steppenhj/Neuro-Drive-CPP/docs/hardware.md

# 하드웨어 부품 목록

Neuro-Drive 프로젝트에 사용된 전체 부품 목록입니다.

---

## MCU / MPU

| # | 구성 | 이름 | 판매처 | 비고 |
|---|---|---|---|---|
| 2 | Raspberry Pi 5 8GB | [정품] 라즈베리파이5 8GB | 아이씨팩토리 | 2/1 쇼트로 인한 고장 |
| 29 | Raspberry Pi 5 4GB | [정품] 라즈베리파이5 4GB | 아이씨팩토리 | 현재 사용 |
| 18 | STM32 NUCLEO-F411RE | ST NUCLEO-F411RE STM32 Nucleo-64 개발보드 | 무원 전자 | SensorECU (Phase 1~5) |
| 33 | STM32 NUCLEO-F446RE | NUCLEO-F446RE | 디바이스마트 | MotorECU (Phase 6 신규) |

---

## 구동계

| # | 구성 | 이름 | 판매처 |
|---|---|---|---|
| 1 | Ackermann 섀시 | 5KG 부하 Ackerman 로봇 자동차 섀시 인코더 모터 전륜 스티어링 RC 탱크 Arduino용 Raspberry Pi 키트 | 알리 |
| 4 | 모터 드라이버 HAT | Waveshare I2C interface Motor Driver HAT Raspberry Pi Onboard PCA9685 Chip | 스마트 유통 |
| 17 | 모터 드라이버 | L298N 모터드라이버 모듈 (방열판 포함) | 엘레파츠 |

> ⚠️ **고장**: #1 Ackermann 섀시의 **조향 서보가 Phase 6(CAN 마이그레이션) 중 소손(탐)** → 현재 구동계 사용 불가. 단순 사고가 아니라 *전진(2번째 MCU + CAN 추가)의 비용* — 이 실패가 multi-mcu-can으로 CAN 멀티노드 기본기를 단단히 다지는 계기가 됨(차량전장·방산 체계통합 직결 자산). Neuro-Drive의 *"실패에서의 재설계"* 와 같은 결.

---

## 전원계

| # | 구성 | 이름 | 판매처 |
|---|---|---|---|
| 5 | 충전기 세트 | IMAX B6 충전기 + 12V 5A 파워서플라이 세트 | 수성RC |
| 8 | LiPo 배터리 | B2200N-SP35 (7.4V, 2S1P, 35C+/JST-XT) 리튬 폴리머 배터리 | 링크드론 |
| 9 | 충전 케이블 | XT60 충전 케이블 | 링크드론 |
| 10 | 배터리-모터드라이버 연결 | XT60H(수) 케이블 연결 커넥터 (10cm) | 링크드론 |
| 25 | 레귤레이터 | UBEC 5A (입력 5V~30V / 출력 5V 5A) | 팰콘샵 |
| 26 | XT60 케이블 | XT60 전원 케이블 (10cm) | 팰콘샵 |
| 27 | 스플리터 | XT60 병렬 커넥터 케이블 Type 2 | 팰콘샵 |
| 28 | UBEC 연결 커넥터 | 와고 전선 커넥터 4SQ 직결 연결 221-2411 | 와고스토어 |
| 31 | 어댑터 | 5V 5A 45W 호환 어댑터 | 아이씨팩토리 |

---

## 통신 / 센서

| # | 구성 | 이름 | 판매처 | 비고 |
|---|---|---|---|---|
| 34 | MCP2515 CAN 모듈 × 2 | MCP2515 + TJA1050 트랜시버 모듈 | 고소미소미 | RPi5 SPI→CAN 인터페이스 |
| 35 | MCP2551 트랜시버 모듈 | MCP2551 CAN 트랜시버 | 농삼비 | F446RE bxCAN 인터페이스 |
| 36 | HC-SR04P 초음파 센서 | HC-SR04P | 디바이스마트 | 장애물 감지 (SensorECU) |
| 37 | 종단 저항 | 120Ω 저항 | 디바이스마트 | CAN 버스 양단 종단 |
| 38 | 브레드보드 | 브레드보드 400홀 | 디바이스마트 | CAN 배선용 |

---

## 카메라

| # | 구성 | 이름 | 판매처 |
|---|---|---|---|
| 21 | 카메라 모듈 | 공식 라즈베리파이 카메라 모듈 3 12MP IMX708 자동초점 120도 | 알리 (IceCrab Store) |
| 22 | 카메라 케이블 | RPi5/Zero용 15핀-22핀 FFC 플렉시블 케이블 | 알리 (IceCrab Store) |
| 23 | 카메라 거치대 | 라즈베리파이 카메라 거치대 브라켓 케이스 | 톡톡테크 |

---

## 저장 / 주변기기

| # | 구성 | 이름 | 판매처 |
|---|---|---|---|
| 3 | 쿨러 | [정품] 라즈베리파이5 액티브 쿨러 | 무원전자 |
| 6 | SD카드 | 샌디스크 Micro SD 128GB | 쿠팡 |
| 7 | SD카드 리더기 | 마이크로 SD카드리더기 C타입 | 아이엠듀 스토어 |
| 19 | Mini USB 2.0 케이블 | — | 쿠팡 |
| 30 | RPi5 케이스 | [정품] 라즈베리파이5 케이스 | 아이씨팩토리 |

---

## 배선 / 소모품

| # | 구성 | 이름 | 판매처 |
|---|---|---|---|
| 11 | 점퍼 케이블 | 40핀 아두이노 점퍼케이블 20cm 암수·암암 | 쿠팡 |
| 12 | 정밀 드라이버 | WERA 2035 전자 정밀 일자(-) 드라이버 | Wera |
| 13 | 스태킹 헤더 | 라즈베리파이 GPIO 스태킹 암 헤더 키트 | 11번가 |
| 14 | 나사 키트 | PCB 황동서포트 120P 키트 M2.5/M3 | 쿠팡 |
| 15 | 케이블 타이 | PA66 케이블타이 대/중/소 각 100개 | 쿠팡 |
| 16 | 덕트 테이프 | 스코라 덕트 테이프 검정 5cm × 15m | 쿠팡 |
| 24 | 점퍼선 (추가) | 20cm 수-수, 암-수 | 쿠팡 |
| 32 | M2.5/M3 나사 키트 | 라즈베리파이용 나일론 나사 너트 키트 20종 | 엠제이로지스트리플 |
