steppenhj/Neuro-Drive-CPP/firmware/F446RE/src/main.h

#define MOTOR_PWM_MAX 999
#define SERVO_MIN_US 650
#define SERVO_MAX_US 2350
#define SERVO_CENTER_US 1500
#define PWM_TO_ENC_SCALE 0.1f
#define B1_Pin GPIO_PIN_13
#define B1_GPIO_Port GPIOC
#define B1_EXTI_IRQn EXTI15_10_IRQn
#define MOTOR_IN1_Pin GPIO_PIN_1
#define MOTOR_IN1_GPIO_Port GPIOA
#define USART_TX_Pin GPIO_PIN_2
#define USART_TX_GPIO_Port GPIOA
#define USART_RX_Pin GPIO_PIN_3
#define USART_RX_GPIO_Port GPIOA
#define MOTOR_IN2_Pin GPIO_PIN_4
#define MOTOR_IN2_GPIO_Port GPIOA
#define LD2_Pin GPIO_PIN_5
#define LD2_GPIO_Port GPIOA
#define TMS_Pin GPIO_PIN_13
#define TMS_GPIO_Port GPIOA
#define TCK_Pin GPIO_PIN_14
#define TCK_GPIO_Port GPIOA
#define SWO_Pin GPIO_PIN_3
#define SWO_GPIO_Port GPIOB
