steppenhj/Neuro-Drive-CPP/phase_history/phase_5_code/OTA.c

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
/* Includes ------------------------------------------------------------------*/
#include "main.h"

/* USER CODE BEGIN Includes */
#include <string.h>
#include <stdio.h>

/* USER CODE END Includes */

/* USER CODE BEGIN PD */
#define APP_ADDRESS 0x08004000 //Application 시작 주소 (Sector 1) 이게 진짜 중요함
#define CHUNK_SIZE 256 //한번에 수신하는 바이트
#define UPDATE_TIMEOUT_MS 3000 //"UPDATE" 대기 시간 (3초)
#define ACK_TIMEOUT_MS 5000  // 청크 수신 타임아웃 (5초)
#define MAX_APP_SIZE ((512-16) * 1024)  //최대 App 크기 (496KB)
/* USER CODE END PD */

UART_HandleTypeDef huart2;

void SystemClock_Config(void);
static void MX_GPIO_Init(void);
static void MX_USART2_UART_Init(void);
/* USER CODE BEGIN PFP */

//함수 프로토타입 추가
void SendString(const char* str);
void JumpToApp(void);
int WaitForUpdateSignal(uint32_t timeout_ms);
HAL_StatusTypeDef EraseAppFlash(void);
HAL_StatusTypeDef WriteChunkToFlash(uint32_t address, uint8_t* data, uint32_t len);
uint32_t CalculateFlashCRC(uint32_t start_addr, uint32_t size);

/* USER CODE END PFP */

/**
  * @brief  The application entry point.
  * @retval int
  */
int main(void)
{

  /* MCU Configuration--------------------------------------------------------*/

  /* Reset of all peripherals, Initializes the Flash interface and the Systick. */
  HAL_Init();

  /* Configure the system clock */
  SystemClock_Config();

  /* Initialize all configured peripherals */
  MX_GPIO_Init();
  MX_USART2_UART_Init();
  /* USER CODE BEGIN 2 */

  //LED 켜기 (부트로더 진입 표시)
  HAL_GPIO_WritePin(LD2_GPIO_Port, LD2_Pin, GPIO_PIN_SET);

  // Step1: 업데이트 신호 대기 (3초)
  if(!WaitForUpdateSignal(UPDATE_TIMEOUT_MS)){
	  //신호 없음 -> 정상 부팅
	  HAL_GPIO_WritePin(LD2_GPIO_Port, LD2_Pin, GPIO_PIN_RESET);
	  JumpToApp();

	  //JumpToApp실패 (App이 없음-그럴 일은 거의 없겠지만) -> LED 빠른 점멸로 표시
	  SendString("NO_APP\r\n");
	  while(1){
		  HAL_GPIO_TogglePin(LD2_GPIO_Port, LD2_Pin);
		  HAL_Delay(200);
	  }
  }

  //Step 2: 업데이트 모드 진입
  SendString("READY\r\n");

  //Step3: 파일 크기 수신 (4바이트, little-endian)
  uint32_t total_size = 0;
  if(HAL_UART_Receive(&huart2, (uint8_t*)&total_size, 4, ACK_TIMEOUT_MS) != HAL_OK) {
	  SendString("ERR_SIZE\r\n");
	  NVIC_SystemReset();
  }

  if(total_size == 0 || total_size > MAX_APP_SIZE){
	  SendString("ERR_RANGE\r\n");
	  NVIC_SystemReset();
  }
  SendString("ACK\r\n");

  //Step4: Flash Erase
  HAL_FLASH_Unlock();

  if(EraseAppFlash() != HAL_OK){
	  HAL_FLASH_Lock();
	  SendString("ERR_ERASE\r\n");
	  NVIC_SystemReset();
  }
  SendString("ACK\r\n");

  //Step5: 바이너리 수신 & Flash Write
  uint32_t received = 0;
  uint8_t chunk[CHUNK_SIZE];

  while(received < total_size){
	  uint32_t to_read = total_size - received;
	  if(to_read > CHUNK_SIZE) to_read = CHUNK_SIZE;

	  //256바이트 단위로 수신 (마지막 청크는 Python이 0xFF 패딩)
	  if(HAL_UART_Receive(&huart2, chunk, CHUNK_SIZE, ACK_TIMEOUT_MS) != HAL_OK){
		  HAL_FLASH_Lock();
		  SendString("ERR_RX\r\n");
		  NVIC_SystemReset();
	  }

	  //Flash에 기록
	  if(WriteChunkToFlash(APP_ADDRESS + received, chunk, CHUNK_SIZE) != HAL_OK) {
		  HAL_FLASH_Lock();
		  SendString("ERR_WRITE\r\n");
		  NVIC_SystemReset();
	  }

	  received += to_read;

	  //ACK 전송 (Python이 다음 청크 전송)
	  SendString("ACK\r\n");

	  //LED 토글 (진행표시)
	  HAL_GPIO_TogglePin(LD2_GPIO_Port, LD2_Pin);
  }

  HAL_FLASH_Lock();

  //Step6: CRC검증
  uint32_t expected_crc = 0;
  if(HAL_UART_Receive(&huart2, (uint8_t*)&expected_crc, 4, ACK_TIMEOUT_MS) != HAL_OK) {
	  SendString("ERR_CRC_RX\r\n");
	  NVIC_SystemReset();
  }

  uint32_t actual_crc = CalculateFlashCRC(APP_ADDRESS, total_size);

  if(actual_crc != expected_crc){
	  SendString("NACK\r\n");
	  NVIC_SystemReset(); //CRC불일치 -> 재부팅 -> 부트로더 재진입
  }

  //Step7 : 성공 -> 재부팅
  SendString("DONE\r\n");
  HAL_Delay(100);
  NVIC_SystemReset();
  //재부팅 후 -> 부트로더 -> 3초대기 -> 신호 없음 -> JumpToApp -> 새 펌웨어

  /* USER CODE END 2 */

  /* Infinite loop */
  /* USER CODE BEGIN WHILE */
  while (1)
  {
    /* USER CODE END WHILE */

    /* USER CODE BEGIN 3 */
  }
  /* USER CODE END 3 */
}

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
/* USER CODE BEGIN 4 */

// 1. UART 문자열 전송 유틸리티
void SendString(const char* str)
{
	HAL_UART_Transmit(&huart2, (uint8_t*)str, strlen(str), 100);
}

// 2. Application으로 점프
typedef void (*pFunction)(void);
void JumpToApp(void)
{
	//(1) App 영역의 첫 4바이트 = Initial Stack Pointer
	uint32_t app_sp = *(volatile uint32_t*)APP_ADDRESS;

	//(2) 그 다음 4바이트 = Reset Handler 주소
	uint32_t app_entry = *(volatile uint32_t*)(APP_ADDRESS + 4);

	//(3) SP가 유효한 SRAM 범위인지 검증
	// STM32F411RE의 SRAM: 0X2000_0000 ~ 0X2002_0000 (128KB)
	if((app_sp < 0x20000000) || (app_sp > 0x20020000)) {
		return; //App 이 없거나 손상됨 -> 부트로더에 머무름
	}

	//(4) 모든 인터럽트 비활성화
	__disable_irq();

	//(5) SysTick 정지 (HAL이 사용하던 타이머)
	SysTick->CTRL = 0;
	SysTick->LOAD = 0;
	SysTick->VAL = 0;

	//(6) Vector Table을 App 주소로 재설정
	SCB->VTOR = APP_ADDRESS;

	//(7) Stack Pointer 설정
	__set_MSP(app_sp);

	//(8) App의 Reset Handler로 점프 (돌아오지 않음)
	pFunction app_reset = (pFunction)app_entry;
	app_reset();
}

// 3. "UPDATE\n" 신호 대기
int WaitForUpdateSignal(uint32_t timeout_ms)
{
	uint8_t rx_buf[8] = {0};
	uint32_t start = HAL_GetTick();
	uint8_t idx = 0;

	while((HAL_GetTick() - start) < timeout_ms) {
		uint8_t byte;
		// 10ms 타임아웃으로 1바이트씩 수신 시도
		if (HAL_UART_Receive(&huart2, &byte, 1, 10) == HAL_OK) {
			if(byte == '\n'){
				rx_buf[idx] = '\0';
				if(strcmp((char*)rx_buf, "UPDATE")==0){
					return 1; //업데이트 요청 확인
				}
				idx = 0; //다른 문자열이면 버퍼 리셋
			} else if (idx < 7) {
				rx_buf[idx++] = byte;
			}
		}
	}
	return 0; //타임아웃 -> 정상 부팅
}


// 4. Application Flash 영역 삭제
HAL_StatusTypeDef EraseAppFlash(void)
{
	FLASH_EraseInitTypeDef erase;
	uint32_t sector_error;

	erase.TypeErase = FLASH_TYPEERASE_SECTORS;
	erase.VoltageRange = FLASH_VOLTAGE_RANGE_3; //2.7~3.6V
	erase.Sector = FLASH_SECTOR_1; // Sector 0 은 절대 건드리지 않음 (부트로더) (1~7까지 지우기)
	erase.NbSectors = 7;

	return HAL_FLASHEx_Erase(&erase, &sector_error);
}

// 5. 수신한 데이터를 Flash에 기록
HAL_StatusTypeDef WriteChunkToFlash(uint32_t address, uint8_t* data, uint32_t len)
{
	for(uint32_t i=0; i<len; i+=4){
		uint32_t word = *(uint32_t*)&data[i];
		if(HAL_FLASH_Program(FLASH_TYPEPROGRAM_WORD, address+i, word) != HAL_OK){
			return HAL_ERROR;
		}
	}
	return HAL_OK;
}

// 6. CRC32 계산 (소프트웨어 구현)
// 원본 데이어와 동일한지 검증. python에 zlib.crc32()로 계산한 값과 비교할 예정
// CRC32는 구글링하면 됨
uint32_t CalculateFlashCRC(uint32_t start_addr, uint32_t size)
{
	uint32_t crc = 0xFFFFFFFF;
	uint8_t* ptr = (uint8_t*)start_addr;

	for(uint32_t i=0; i<size; i++){
		crc ^= ptr[i];
		for(int j=0; j<8; j++){
			crc = (crc >> 1) ^ (0xEDB88320 & -(crc & 1));
		}
	}
	return crc ^ 0xFFFFFFFF;
}

/* USER CODE END 4 */
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
