steppenhj/Neuro-Drive-CPP/(commit log)

2025-12-19 README에 참고논문 적음
2025-12-20 조이스틱으로 바꿈. 그리고 C++도 설계를 조금 진행했음.
2025-12-27 웹 소켓 방식으로 수정, 조이스틱 if(isTouching) sendData 추가 -> 한 방향 계속 누를 때 인식하는 방법
    [app.py]
2026-01-04 수동 주행 테스트 코드 작성
2026-01-04 통합 테스트 코드 생성 및 모바일 테스트 환경 구축
2026-01-06 속도 제한 풀고(테스트 성공), 안전 장치 추가(와이파이 끊기면 정지)
2026-01-08 ReadMe 수정 -> 4단계 작성
    [drive_server.cpp]
2026-01-15 Phase2 시작, phase1은 폴더에 정리
2026-01-20 엔코더 연결 및 인식까지 완성
2026-01-25 카메라까지 추가
2026-01-27 phase 2 완성, 펌웨어 코드도 추가
2026-02-05 새로운 RPi 칩 처음 커밋임. CPP로 계산로직 이동
2026-02-05 CPP 추가.계산 로직 마이그레이션
2026-02-05 멀티스레드 cpp에 추가. 테스트는 아직 안 함
2026-02-07 멀티스레드, upd 수정
2026-02-07 리드미 대폭 수정
2026-02-09 모바일 가로모드 적용
    [data_log.csv]
2026-02-09 카메라 관련 로직은 다 빼고 phase 3까지 테스트 완
2026-02-11 복습 후 주석 추가
2026-02-16 객체지향 리팩토링
2026-02-26 PID 제어 시작
2026-02-27 RTH 추가 / 테스트는 아직
2026-03-02 Folder정리/Phase4 완료/리드미 정리
    [data_log.csv]
2026-03-02 ReadMe오류 수정
2026-03-02 phase 4에 cpp 코드도 추가 (누락)
2026-03-02 RTH 기능 정밀화
2026-03-02 Diagram 변경사항 적용
2026-03-05 Phase5 OTA 기능 구현
2026-03-09 feat: Phase 5 codes 추가
2026-03-24 feat: C++ 다시 리팩토링, 테스트 완료
2026-03-24 feat: Phase 6 이전, Ping-Pong: 40ms나옴
2026-04-23 refactor: add some comments about PID control
2026-04-23 feat: delete Python boost, i will use PID
2026-04-23 feat: firmware-> pwm-encoder-PID
2026-04-23 fix: fix some bugs about PID
    [main.c]
2026-04-24 fix: fix some bugs about Race Condition at ISR
    [main.c]
2026-04-24 feat: 0.5->3.0 (kp, PID)
2026-04-24 chore: .bin build 산출물 gitignore
2026-04-26 refactor: delete driver.h file
2026-04-28 chore: add STM32CubeIDE project files (.ioc)
2026-04-29 fix: fix pin connection bug
2026-04-29 feat: add TJA1050 and 120 옴 term
2026-05-01 feat: add F446RE CAN Wiring by using html
2026-05-04 현재 L298N 혹은 Servo가 탔다 | F446RE로 넘어가는 도중
2026-05-05 feat: add firmware and i should think how to handle this problem
    [Phase6_CAN.ioc, main.c]
2026-06-23 docs: clarify CAN wiring tool description in README
2026-06-23 docs: 스레드 멤버변수 수명 관련 주석 추가
2026-06-29 docs: 하드웨어 상태 업데이트
2026-06-30 docs: 사진 추가
2026-06-30 docs: 사진 크기 수정
2026-07-03 docs: 리드미 틀린 표현 수정
2026-07-04 docs: 링버퍼 설명 주석 추가
2026-07-21 fix: RTH 복귀 중 통신 두절 시 FAIL_SAFE 정지 구현
    기존에는 rth_mode==2 && timeout일 때 아무 명령도 전송되지 않아 마지막 모터 명령이 유지됐다 (상태차트의 RTH_ACTIVE -> FAIL_SAFE 전이 누락). 제어 루프에서 매 틱 정지 명령(0, 1500)을 전송하도록 수정하고, 안전 정책(fail-stop, RTH는 감독 하 자율 + dead-man switch) 주석을 추가.
    [control_core_oop.cpp]
2026-07-21 chore: .gitignore깨진 첫 줄 수정(주석이 패턴에 붙어 있던 것 분리)
2026-07-22 docs: 잘못된 부분 수정
2026-07-22 fix: UDP 입력 검증 추가 (NaN Inf 폐기, 조종값 클램프, 모드 화이트리스트)
    [control_core_oop.cpp]
2026-07-22 fix: 시리얼 실패 시 미초기화 fd 사용 방지 (feedback 소켓 생성자 이동, PING write가드)
    [control_core_oop.cpp]
2026-07-22 chore: 생성자 초기화 리스트 정리, 주석 처리된 잔재 코드 제거
2026-07-22 fix: RTH 경로 수명 관리 (기록 재시작 시 초기화, 복귀 이탈 시 폐기)
    [control_core_oop.cpp]
2026-07-22 docs: PID 관련 주석 추가
2026-07-23 docs: main.c 설계 근거 주석 추가 (클럭 타이머 ISR 태스크 구조)
2026-07-23 fix: popLine 잘림 시 잔여물 소비 (유령 줄 방지), 미사용 count 제거
    [control_core_oop.cpp]
2026-07-23 docs: 로드맵 표의 2-DOF 표현을 실제 제어 구조에 맞게 수정
2026-07-26 docs: 조향 서보 소손 장애 분석 추가 (출력 타이머 매핑 스왑, 커밋 역추적으로 원인 확정)
    Phase 6 이식 후 큐 지연을 수정하는 과정에서 모터/서보 출력 타이머가 뒤바뀌어, 배선이 그대로인 상태에서 조향 서보에 스로틀 값이 위치 명령으로 인가됨. 기계적 한계에서 스톨 전류가 지속되어 소손. 비상정지 로직도 같은 편집에서 함께 뒤집혀 안전장치가 작동 불가했음(공통원인고장).
    정상 주행(c89a1a2) → 매핑 스왑(fa7c792) → ioc 사후 조정(084964c)으로 이어지는 변경 사슬을 역추적해 발생 약 3개월 뒤 확정.
2026-07-26 docs: F446RE 서보 소손 원인 지점 주석 표시 (freertos.c 출력 매핑)
2026-07-26 docs: 학교 문구 삭제
