steppenhj/Neuro-Drive-CPP/(notices)

Notices in the files:
firmware/F446RE/src/main.h:
Copyright (c) 2026 STMicroelectronics.
All rights reserved.
This software is licensed under terms that can be found in the LICENSE file
